ShoulongLinn/CIAE_PSdetector/readme.md

# CIAE plastic detector doc and readout system 
## Documentation
## simulation
