ShoulongLinn/CIAE_PSdetector/simulation/LTC6752_TOT withbuffer.asc

C1: cap; 50p
C2: cap; 50p
I1: current; PULSE(0 2m 0.2u 5n 100n 0 1)
I2: current; PULSE(0 2m 0.2u 5n 100n 0 1)
R1: res; 10k
R2: res; 10k
R3: res; 2k
R4: res; 2k
U1: LTC6752
U2: ADA4891
U3: ADA4891-4
U4: ADA4891-4
U5: LTC6752
U6: ADA4891
U7: ADA4891-4
V1: voltage; 5
V2: voltage; 50m
V3: voltage; 5
V4: voltage; 50m
Named nets: 0
.tran 5u
