ShoulongLinn/CIAE_PSdetector/simulation/LTC6752_TOT.asc

C1: cap; 50p
I1: current; PULSE(0 2m 0.2u 5n 100n 0 1)
R1: res; 10k
R2: res; 10K
R3: res; 2k
U1: LTC6752
U2: ADA4891
V1: voltage; 5
V2: voltage; 50m
Named nets: 0
.tran 5u
